amacn028/uORover-LDM-Power-PCB/README.md

# uORover-LDM-Power-PCB
Power delivery PCB for various subsystems of the (LDM) Life Detection Module subsystem of the uOttawa Mars Rover. See the report for an overview of the project.
