amacn028/uORover-LDM-Power-PCB/LDM power delivery project_final_report.pdf

Life Detection Module ( LDM) Power Delivery PCB Project:

Aaron MacNeil
7-Jun-2025
Introduction: | 2
Overview of the project: | 2
Table 1: Life Detection Module Motors’ respective current loads and specs for design | 2
Body: | 5
Figure 2: Schematic of the LDM power delivery PCB | 5
Figure 3: 4-layer stackup of the LDM power delivery PCB | 5
Figure 4: 2D view of the LDM power delivery PCB | 6
Figure 5: 3D view of the LDM power delivery PCB | 7
Figure 6: Bill of materials for the LDM power delivery PCB | 8
Figure 7: Buck converter design using Texas Instruments’ Webbench design tool | 9
Figure 8: Design parameters from the buck converter design using Texas Instruments’
Webbench design tool | 10
Figure 9: Bode plot from the buck converter design using Texas Instruments’ Webbench
design tool | 10
Figure 10: Load transient from the buck converter design using Texas Instruments’
Webbench design tool | 11
Figure 11: startup transient from the buck converter design using Texas Instruments’
Webbench design tool | 12
Figure 12: Buck converter design using Texas Instruments’ buck converter design tool part 1 13
Figure 13: Buck converter design using Texas Instruments’ buck converter design tool part 2 13
Figure 14: Buck converter design using Texas Instruments’ buck converter design tool part 3 14
Figure 15: EMI input filter of buck converter design using white paper recommendations
from Texas Instruments’ | 14
Conclusion: | 15
References: | 16

# Introduction:

The goal of this project is to design a power delivery system and PCB for the Life Detection Module of the uOttawa Mars Rover. The Life Detection Module is facilitates various tasks involved in collecting soil samples for future analysis. These tasks involve DC motors for drilling and for vacuuming up the soil, stepper and servo motors for positioning of the Life Detection Module “arm” during soil sample collection, and a linear actuator to extend or retract the arm at the start and end of the soil collection process. This project had some significant challenges including: high current carrying capability of the PCB, facilitating wired connections into and out of the PCB through various interconnects, ensuring proper safety features , integrating analog current sensors for current monitoring, and ofcourse the standard challenges associated with any PCB design ( EMI reduction, size constraints, component and material selection, DFM requirements etc). From thorough testing, planning, design, and a few iterations: the resulting project is a power delivery system capable of providing the demands of all load devices required in the Life Detection Module.

# Overview of the project:

When I was first approached by the uOttawa Mars Rover Electrical Systems subteam leader about the project, I had minimal experience with PCB design, especially for something as complex as the power delivery system for this Life Detection Module. However, I was excited to take this opportunity to stretch my skillset and expand my capabilities. I knew that this was exactly the type of challenge I was looking for in my next project. The design process began by meeting the Life Detection subteam leader to discuss the design requirements of the project, as well as stress test the max loading conditions to be expected from each of the respective motors used in the Life Detection Module. Below is a table of the stress testing current measurements and the agreed upon design specifications for each individual motor:

Table 1: Life Detection Module Motors’ respective current loads and specs for design

motor: | current testing measurements( max draw) : | spec ( with tolerance)
vacuum motor | 10.7A | 15A
drill motor(no load) | starts( 8A), continuous (2A) | N.A.
drill motor( loaded/stall torque) | 40A | 53A max capable, limit to 30A
linear actuator | 2.3A | 5A
stepper | 0.25A | 0.5A
servo | 0.05A | 0.1A

From these design specifications, along with requirements specified by both the Electrical Systems and Life Detection subteam leaders about parts inventory and coherence with other related electrical systems on the Mars Rover, the component selection process could begin. It is worth noting a few features about the system:
- The drill motor requires its own separate source from the main power delivery system’s auxiliary port. Everything else is sourced from another port from the main power delivery system. That is to say, there are two input ports into this PCB.
- The drill motor, vacuum motor, and linear actuator motor must go through individual Spark motor controllers via screw terminal/XT90 connections over 12 awg gauge wire. This meant integrating screw terminals on the PCB to facilitate power delivery both into and out of the PCB at various stages in the power flow chain.
- The drill motor, vacuum motor, and linear actuator motor must go through individual analog current sensors so that the current draw of each can be monitored.This also invoked the need for header connections for communication with a microcontroller.
- A 12V-to-5V buck converter and subsequent 5V rail power supply was implemented to power the soil stepper motor, the drill/vacuum stepper motor, the soil servo motor, respective motor controllers, and the respective current sensors involved in the power delivery system. This additional power supply also invoked the associated EMI filter design at the input of the buck converter.
- Some of the design choices were dictated by preferences from both subteam leaders, including the use of XT90 connectors, the use of the Spark motor controllers, and the use of PCB standoffs for easy implementation and replacement of the stepper motor controller breakout board PCBs instead of integration of these motor controllers directly on the main PCB.

An overview of the Life Detection Module power delivery system design is shown in the block diagram below:

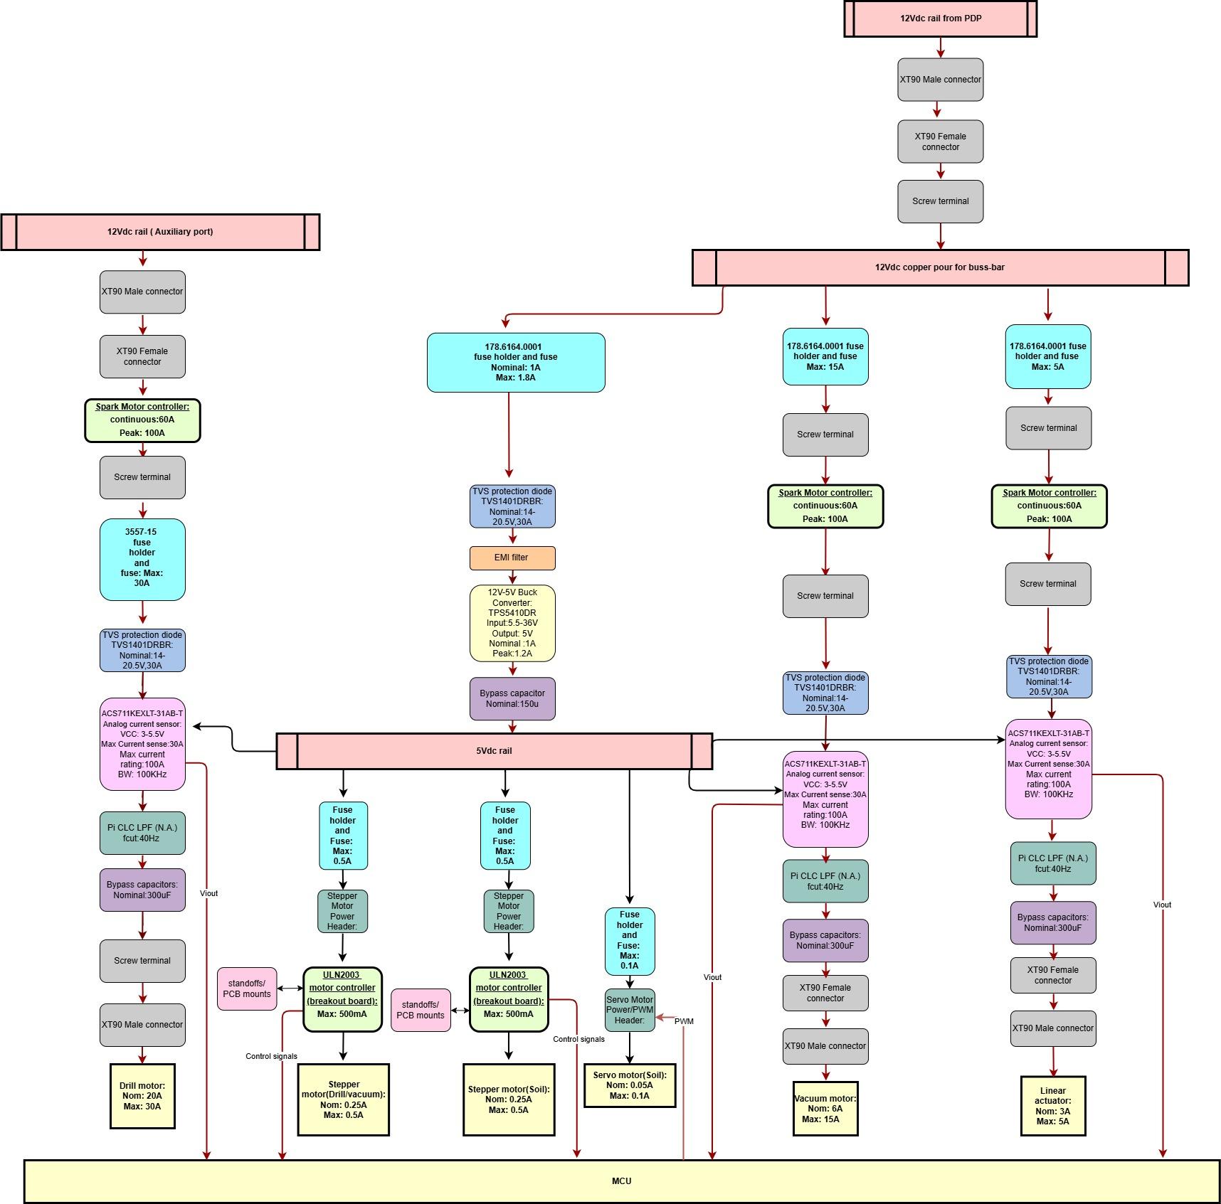
[picture p1: figure]

Figure 1:Block diagram of the overall LDM power delivery system

# Body:

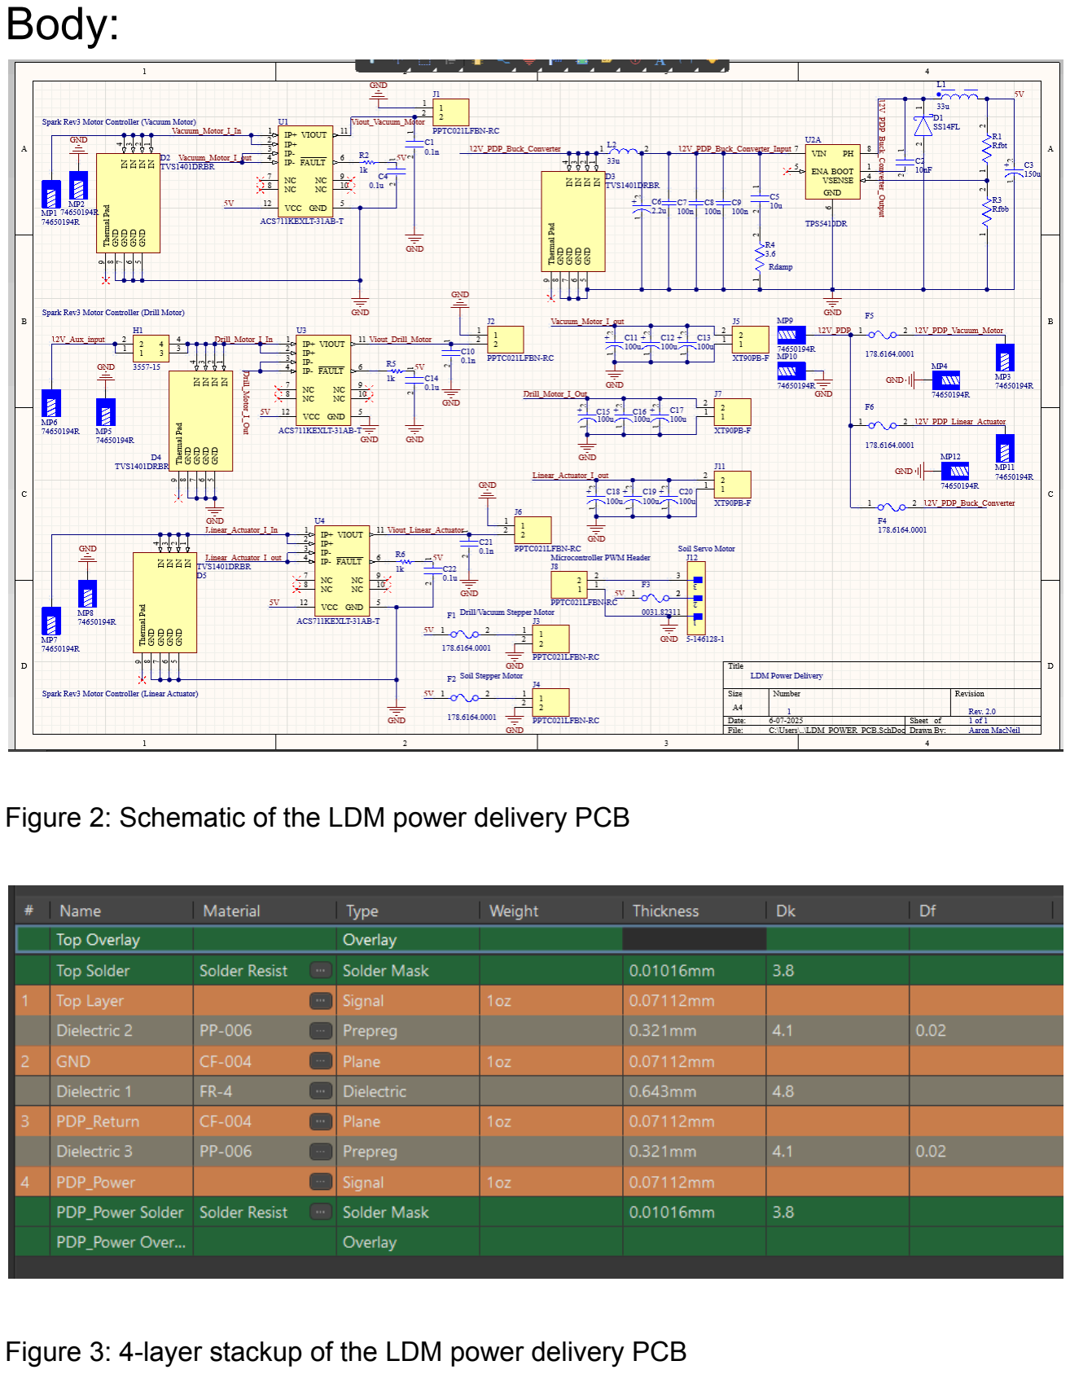
[picture p2: page 5]

Figure 2: Schematic of the LDM power delivery PCB

Figure 3: 4-layer stackup of the LDM power delivery PCB

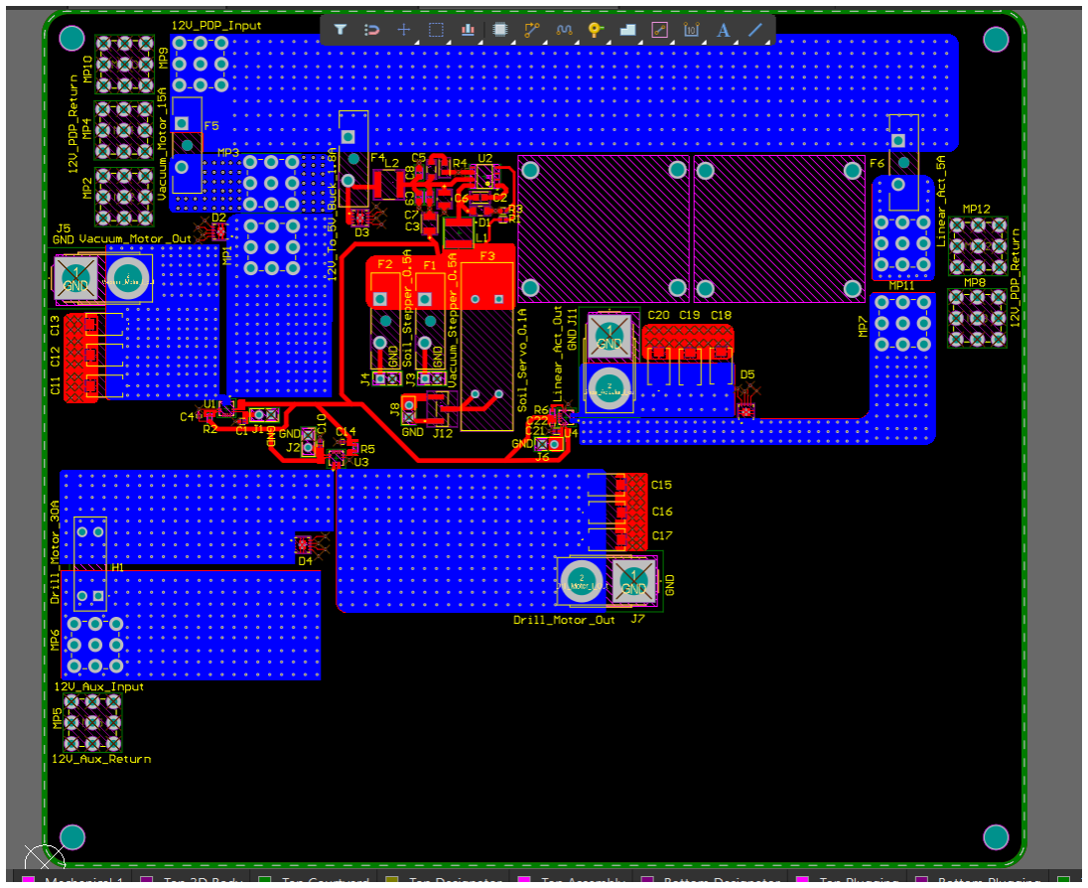
[picture p3: figure]

Figure 4: 2D view of the LDM power delivery PCB

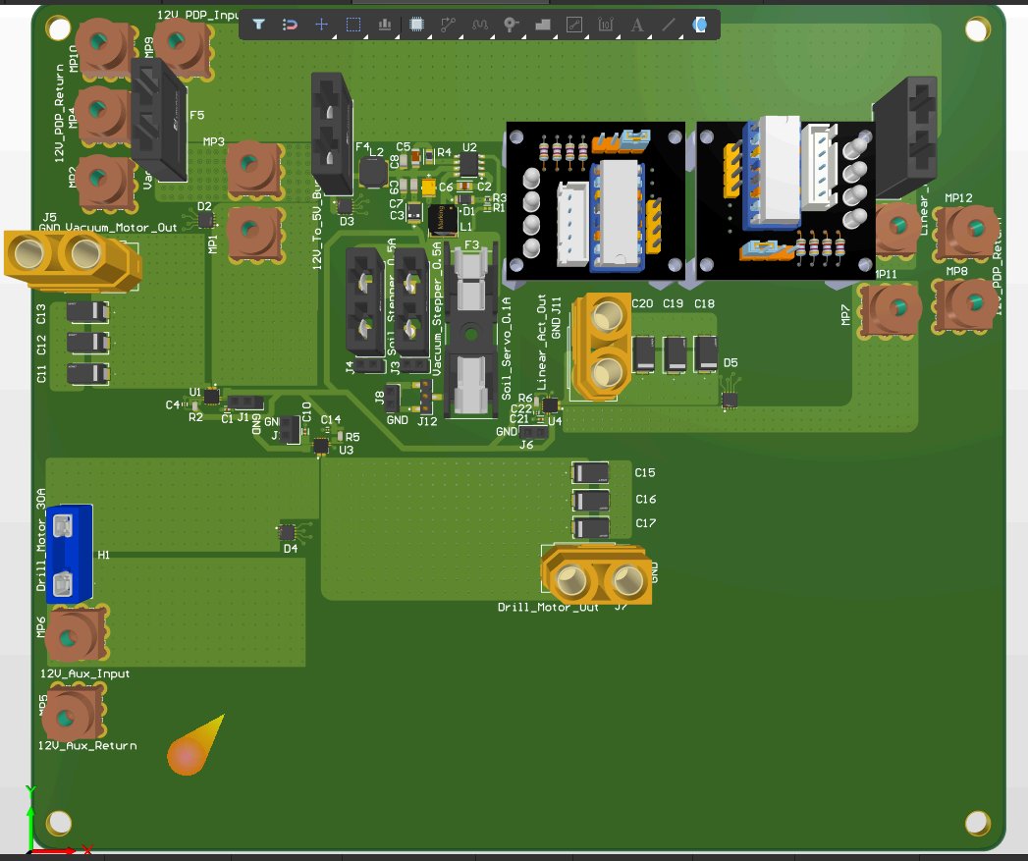
[picture p4: figure]

Figure 5: 3D view of the LDM power delivery PCB

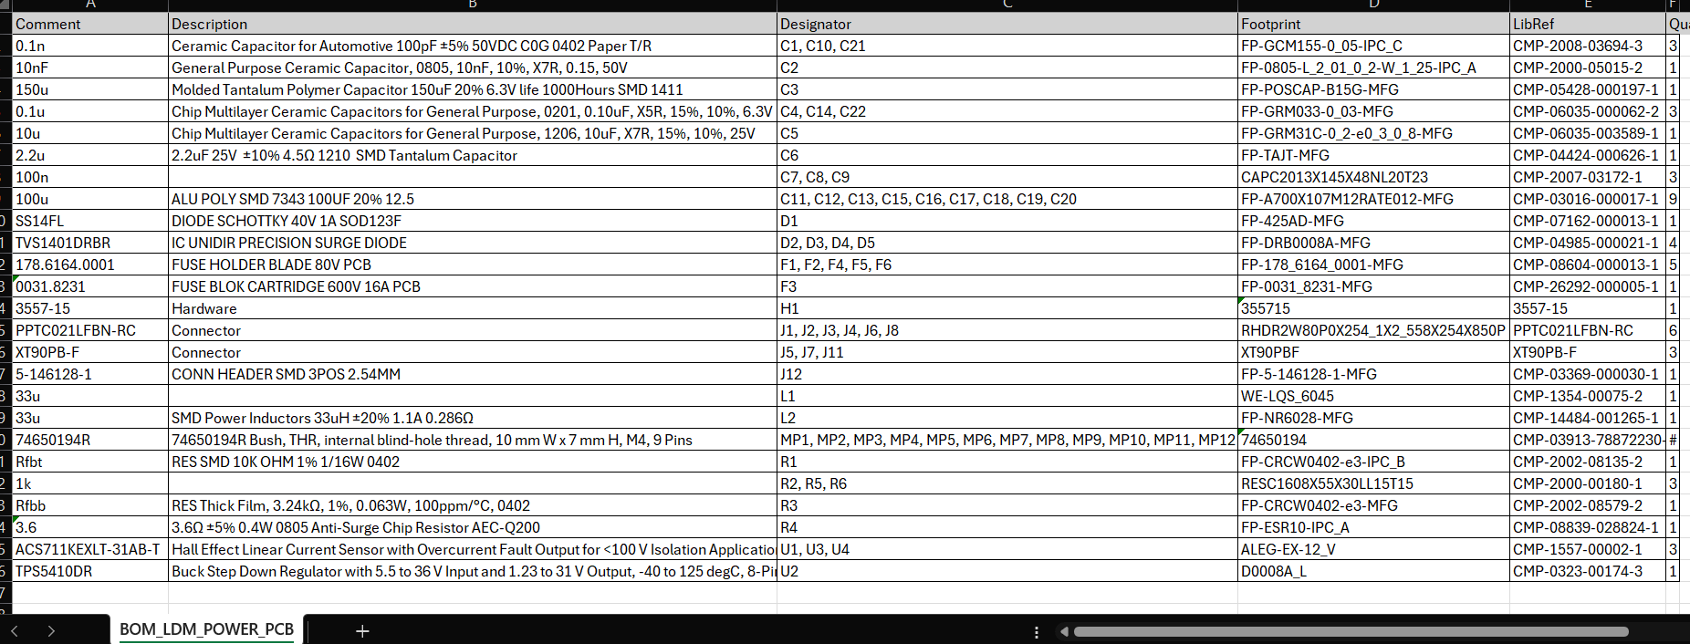
[picture p5: figure]

Figure 6: Bill of materials for the LDM power delivery PCB

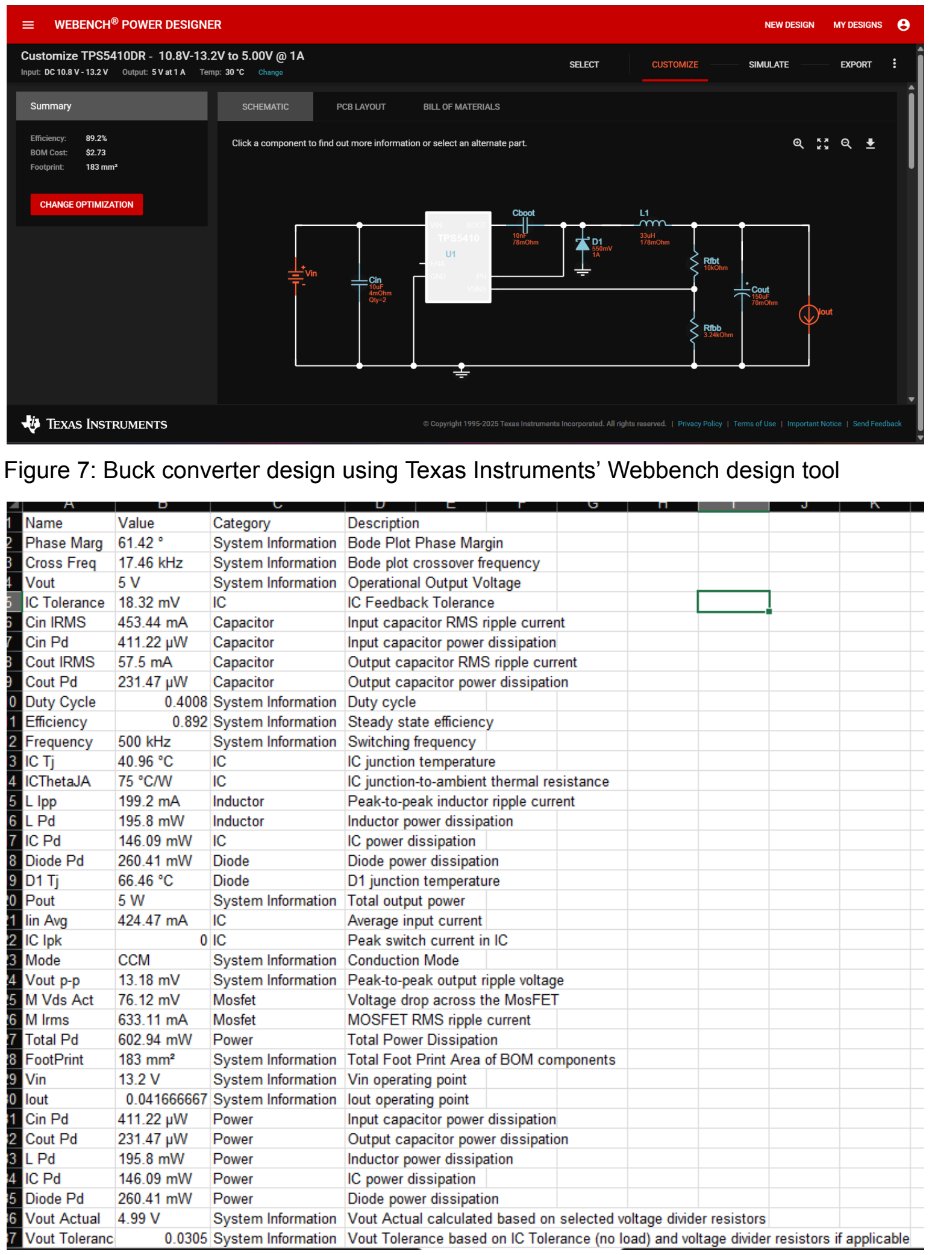
[picture p6: page 9]

Figure 7: Buck converter design using Texas Instruments’ Webbench design tool

Figure 8: Design parameters from the buck converter design using Texas Instruments’ Webbench design tool

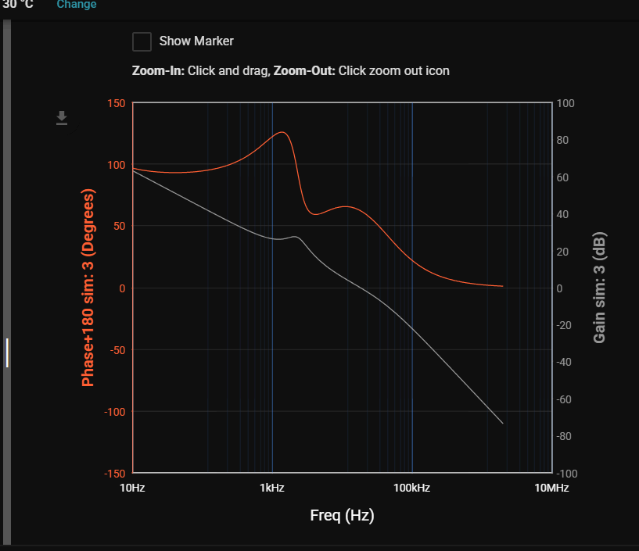
[picture p7: figure]

Figure 9: Bode plot from the buck converter design using Texas Instruments’ Webbench design tool

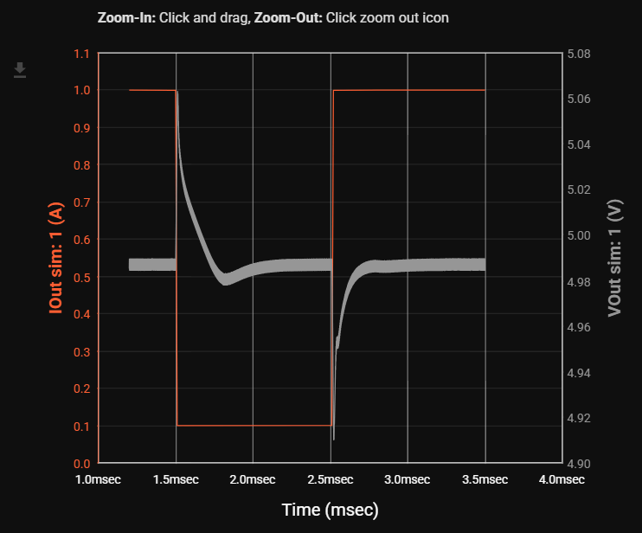
[picture p8: figure]

Figure 10: Load transient from the buck converter design using Texas Instruments’ Webbench design tool

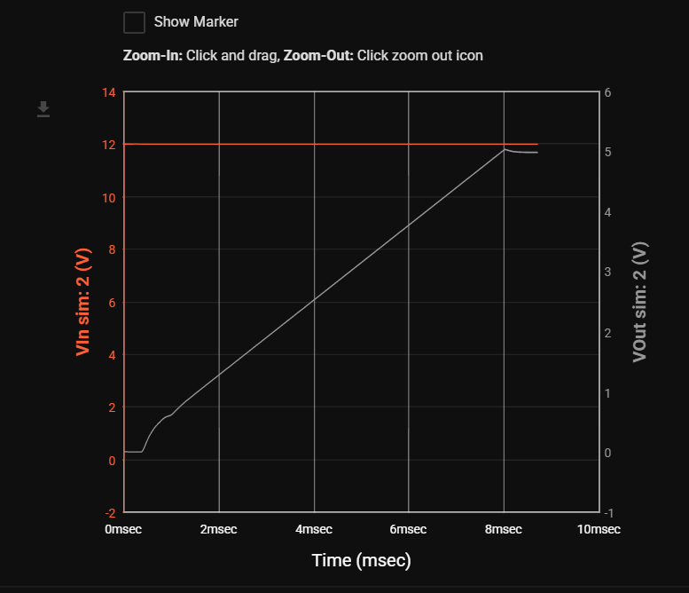
[picture p9: figure]

Figure 11: startup transient from the buck converter design using Texas Instruments’ Webbench design tool

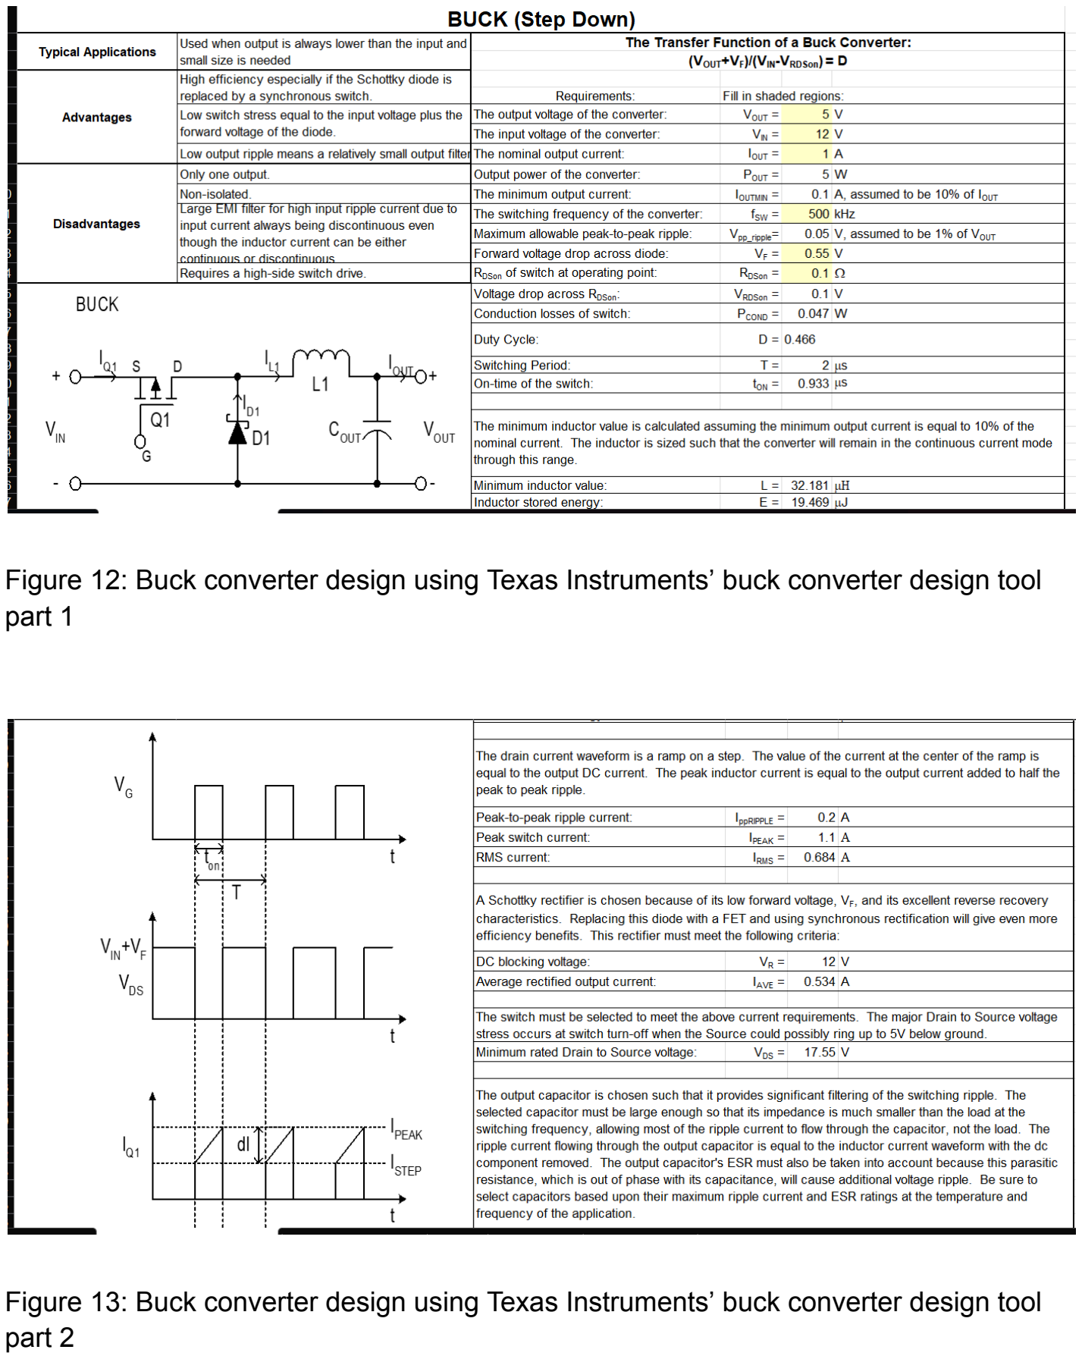
[picture p10: page 13]

Figure 12: Buck converter design using Texas Instruments’ buck converter design tool part 1

Figure 13: Buck converter design using Texas Instruments’ buck converter design tool part 2

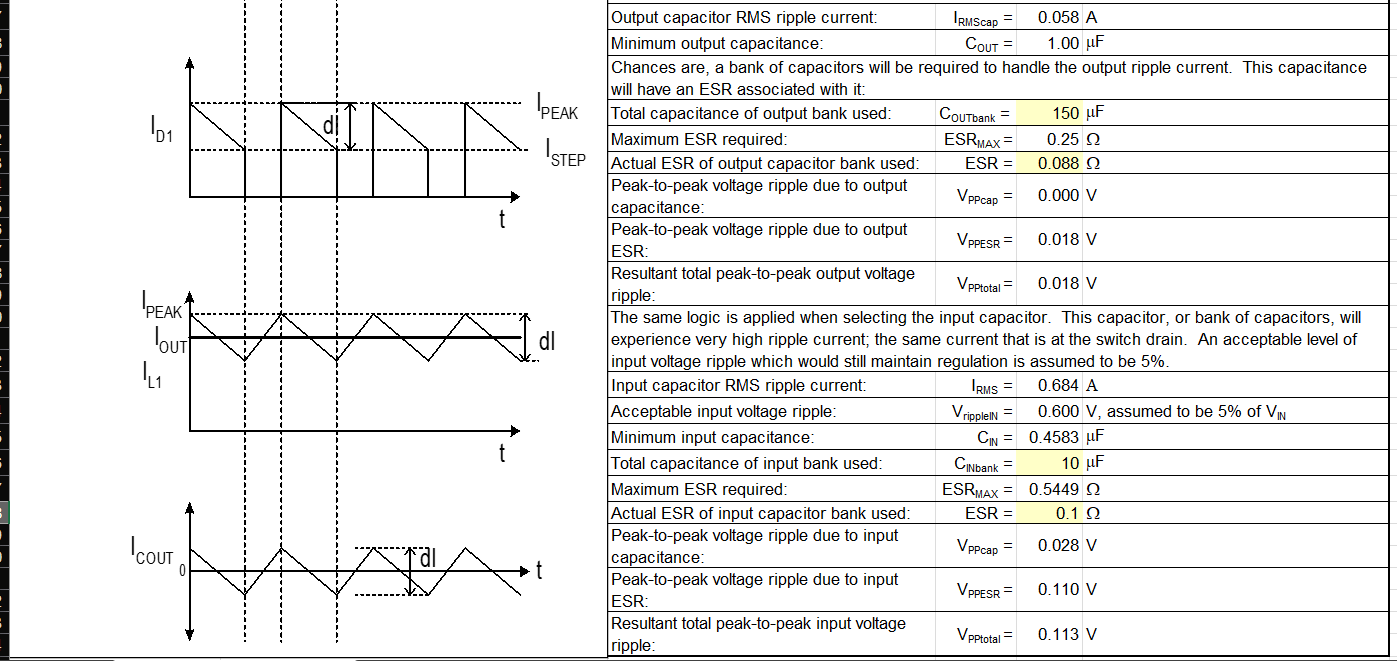
[picture p11: figure]

Figure 14: Buck converter design using Texas Instruments’ buck converter design tool part 3

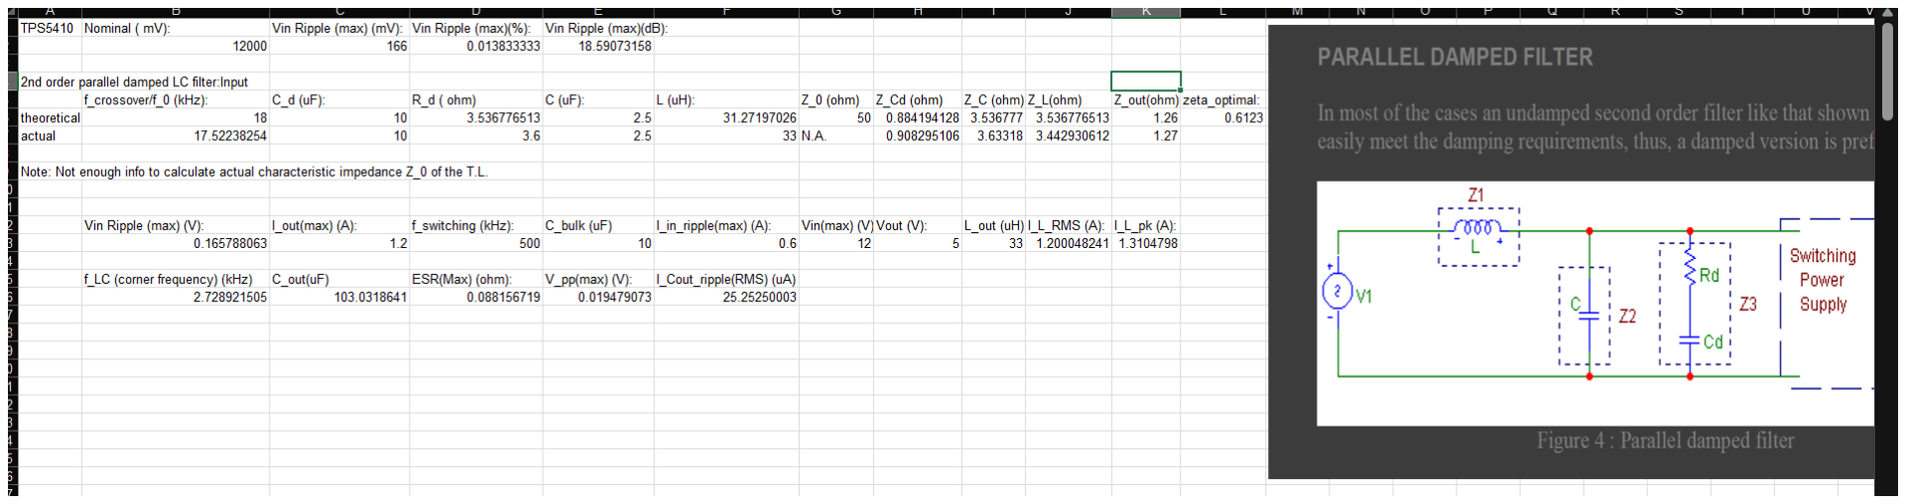
[picture p12: figure]

Figure 15: EMI input filter of buck converter design using white paper recommendations from Texas Instruments’

The PCB stackup is a typical 4-layer stackup, with standard overall thickness of 1.57mm.The material choice per layer was made based on availability within the Altium library. The layer thickness choice of 1oz per layer was recommended by the Electrical Systems subteam leader. The design choices of trace width for current capacity, via quantity and spacing on stitched via polygons, characteristic impedance,EMI filter design, and various other design choices were made by: referencing the material in the references, from design recommendations from device datasheets , and from Texas Instruments’ Webbench design and Buck Converter Design tools.Design choices on via types, via diameter, via hole size, as well as trace widths, were all made by referencing the JLC PCB DFM capabilities w since this is the usual vendor selected by the uOttawa Mars Rover team. More specific details on the design choices and calculations are included in the associated excel documents of the project.

Design challenges:
- Integrating 12 awg wire interconnects with the PCB traces into and out of board for the motor controllers and the motors themselves.
- Optimizing PCB spacing and component placement on the board.
- Current carrying capacity of respective motor supply lines.

Design solutions:
- Strategic placement of XT90 connectors, screw terminals,and bus bar copper pours on the PCB to pop in and out of the PCB where needed.
- Careful planning and iterative testing in the component placement stage before routing.
- Using IPC 2221 formulas and parameters to calculate the minimum copper pour width ,minimum via spacing of the stitching vias, via type, via hole size, and via pad diameter needed to carry the required current through the copper pour and ensure current flow between both top and bottom layers of the stitched copper pours.

# Conclusion:

This project presented an exciting new challenge for me. It was my first real opportunity to implement a PCB design entirely on my own, as well as my first opportunity designing a power delivery system.This design proposed an unconventional challenge of interfacing 12 awg gauge wire connections into and out of the PCB, as well as integrating the various motor controllers and analog current sensors with the microcontroller. I received some initial guidelines from the Electrical Systems and Life Detection subteam leader; after which, I was granted full autonomy on the design and implementation of the PCB. I am grateful to both subteam leaders for entrusting me with the opportunity to produce a design which would meet the needs of the Life Detection Module of the uOttawa Mars Rover.I enjoyed learning how to use the Altium Designer software, as well as other PCB-specific calculations and tools, along with the theory I have been studying in my EE undergrad, in order to deliver a fully-functioning power delivery system for the uOttawa Mars Rover. Overall this project has been a fun challenge with many lessons learned along the way, and I am grateful to have had the opportunity to pursue this project while in my final year of my EE undergrad. As I graduated this year, I am leaving this design in the capable hands of the Electrical Systems and Life Detection subteam leaders for purchasing, testing, and potential iterations as needed.I wish them the best of luck in their future endeavours with the uOttawa Mars Rover team!

# References:

Printed Circuit Board. (2024, April). Should you place bypass capacitors? Retrieved from https://www.printedcircuitboard.org/2024/04/should-you-place-bypass-capacitors.html

Instructables. (n.d.). 28BYJ‑48 5V Stepper Motor and A4988 Driver. Retrieved from https://www.instructables.com/28BYJ-48-5V-Stepper-Motor-and-A4988-Driver/reddit.com+9resources.altium.com+9optimumdesign.com+9 (https://resources.altium.com/p/should-you-place-bypass-capacitors-before-or-after-the-circuit)youtube.com+15instructables.com+ 15forum.dronebotworkshop.com+15 (https://www.instructables.com/28BYJ-48-5V-Stepper-Motor-and-A4988-Driver/?utm_source=chatgpt.com)

LastMinuteEngineers. (n.d.). A4988 stepper motor driver Arduino tutorial. Retrieved from https://lastminuteengineers.com/a4988-stepper-motor-driver-arduino-tutorial/youtube.com+2makerguides.com+2reddit.com+2 (https://www.makerguides.com/a4988-stepper-motor-driver-arduino-tutorial/?utm_source=chatgpt.com)

Texas Instruments. (n.d.). SLVAE37: [Title not specified]. Retrieved from https://www.ti.com/lit/an/slvae37/slvae37.pdf?ts=1746503933649

Texas Instruments. (n.d.). SNVA538: [Title not specified]. Retrieved from https://www.ti.com/lit/an/snva538/snva538.pdf

Renesas Electronics Corporation. (n.d.). AN1325: Choosing and using bypass capacitors. Retrieved from
https://www.renesas.com/en/document/apn/an1325-choosing-and-using-bypass-capacitors

Pololu. (n.d.). A4988 stepper motor driver carrier. Retrieved from https://www.pololu.com/docs/0J15/9 instructables.com+15pololu.com+15pololu.com+15 (https://www.pololu.com/product/1182?utm_source=chatgpt.com)

CalculatorEdge. (n.d.). Pi low‑pass filter calculator. Retrieved from http://www.calculatoredge.com/electronics/ch%20pi%20low%20pass.htm calculatoredge.com+1calculatoredge.com+1 (https://www.calculatoredge.com/electronics/ch%20pi%20low%20pass.htm?utm_source=chatgpt.com)

Texas Instruments. (n.d.). SLUA929A: [Title not specified]. Retrieved from https://www.ti.com/lit/an/slua929a/slua929a.pdf?ts=1746624433739

Analog Devices community. (n.d.). How to choose the crossover frequency for switching power supplies. Retrieved from
https://ez.analog.com/power/w/documents/30076/how-to-choose-the-crossover-frequency-for-s witching-power-supplies (https://ez.analog.com/power/w/documents/30076/how-to-choose-the-crossover-frequency-for-switching-power-supplies)

Digi-Key Electronics. (n.d.). PCB trace‑width conversion calculator. Retrieved from https://www.digikey.ca/en/resources/conversion-calculators/conversion-calculator-pcb-trace-widt h (https://www.digikey.ca/en/resources/conversion-calculators/conversion-calculator-pcb-trace-width) tme.eu+1blogs.sw.siemens.com+1 (https://www.tme.eu/Document/25459777e672c305e474897eef284f74/POLOLU-2128.pdf?utm_source=chatgpt.com)digikey.com (https://www.digikey.com/en/resources/conversion-calculators/conversion-calculator-low-pass-and-high-pass-filter)

Altium Resources. (n.d.). PCB trace width vs current (high voltage design). Retrieved from https://resources.altium.com/p/pcb-trace-width-vs-current-table-high-voltage-design

Altium Resources. (n.d.). Using IPC‑2152 calculator & design standards. Retrieved from https://resources.altium.com/p/using-ipc-2152-calculator-designing-standards

Altium Resources. (n.d.). How to calculate PCB power‑plane current capacity. Retrieved from https://resources.altium.com/p/how-calculate-pcb-power-plane-current-capacity

ReversePCB. (n.d.). PCB trace width calculator. Retrieved from https://reversepcb.com/pcb-trace-width-calculator/

Altium Resources. (n.d.). Copper Pour and Stitching: Do you need them? (PCB layout). Retrieved from
https://resources.altium.com/p/copper-pour-and-stitching-do-you-need-them-pcb-layout

Altium Resources. (n.d.). Everything you need to know about stitching vias. Retrieved from https://resources.altium.com/p/everything-you-need-know-about-stitching-vias

Circuit Calculator. (2006, March 12). PCB via calculator. Retrieved from https://circuitcalculator.com/wordpress/2006/03/12/pcb-via-calculator/

DiskMFR. (n.d.). PCB short circuits & pad peeling: 80+ ignore‑these tips. Retrieved from https://www.diskmfr.com/pcb-short-circuits-pad-peeling-80-ignore-these-tips/#elementor-toc__he ading-anchor-4 (https://www.diskmfr.com/pcb-short-circuits-pad-peeling-80-ignore-these-tips/)

MakerGuides. (2019, April). ULN2003 stepper motor driver PCB [PDF]. Retrieved from https://www.makerguides.com/wp-content/uploads/2019/04/ULN2003-Stepper-Motor-Driver-PC B.pdf (https://www.makerguides.com/wp-content/uploads/2019/04/ULN2003-Stepper-Motor-Driver-PCB.pdf)

Altium Resources. (n.d.). PCB size and pad size guidelines. Retrieved from https://resources.altium.com/p/pcb-size-and-pad-size-guidelines

Cadence PCB Design & Analysis. (2024). High current PCB design guidelines for reliability. Retrieved from
https://resources.pcb.cadence.com/blog/2024-high-current-pcb-design-guidelines-for-reliability
