amacn028/uORover-LDM-Power-PCB/LDM_block_diagram.drawio.pdf

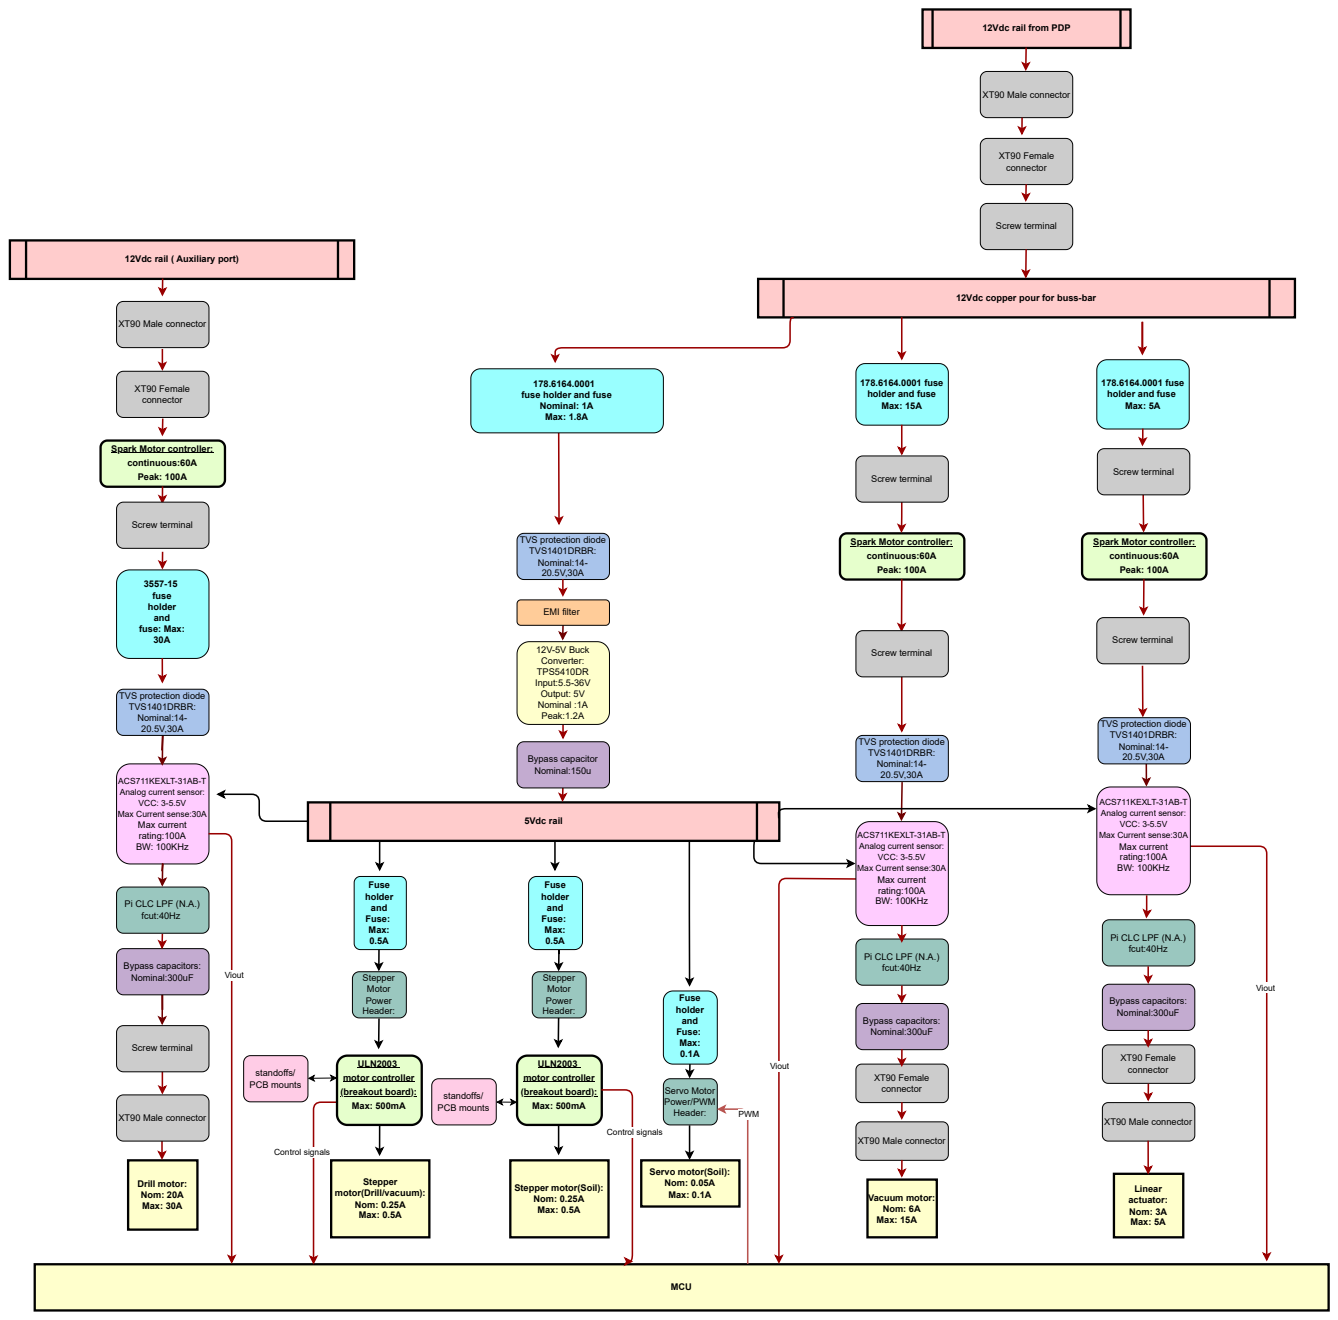
[picture p13: page 1]
MCU; 5Vdc rail; Viout; rating:100A BW: 100KHz; Control signals; ULN2003 motor controller; Fuse: Max: 0.5A; fuse: Max: 30A; 12V-5V Buck Converter: TPS5410DR; Peak:1.2A; Fuse: Max: 0.1A; Header:; EMI filter; Screw terminal; XT90 Female connector; XT90 Male connector

12Vdc rail from PDP

12Vdc rail ( Auxiliary port)

12Vdc copper pour for buss-bar

fuse holder and fuse Nominal: 1A Max: 1.8A

178.6164.0001 fuse holder and fuse Max: 15A

178.6164.0001 fuse holder and fuse Max: 5A

Spark Motor controller:
continuous:60A
Peak: 100A

TVS protection diode TVS1401DRBR: Nominal:14- 20.5V,30A

fuse holder and

Input:5.5-36V Output: 5V Nominal :1A

Bypass capacitor Nominal:150u

ACS711KEXLT-31AB-T Analog current sensor: VCC: 3-5.5V Max Current sense:30A Max current

Fuse holder and

Pi CLC LPF (N.A.)
fcut:40Hz

Bypass capacitors: Nominal:300uF

Stepper Motor Power Header:

standoffs/ PCB mounts

(breakout board): Max: 500mA

Servo Motor Power/PWM

PWM XT90 Male connector

Servo motor(Soil): Nom: 0.05A Max: 0.1A

Drill motor: Nom: 20A Max: 30A

Stepper motor(Drill/vacuum): Nom: 0.25A Max: 0.5A

Stepper motor(Soil): Nom: 0.25A Max: 0.5A

Linear actuator: Nom: 3A Max: 5A

Vacuum motor: Nom: 6A Max: 15A
