amacn028/uORover-LDM-Power-PCB/(list of files, drawings)

Other design files:
LDM_POWER_PCB.PrjPcb
LDM_POWER_PCB.SchDoc
